paweljw/pomidor/bom.csv

ID | Name | Designator | Footprint | Quantity | Manufacturer Part | Manufacturer | Supplier | Supplier Part
1 | SK12D07VG4 | SW1,SW2 | SW-TH_SK12D07VG4 | 2 | SK12D07VG4 | SHOU HAN | LCSC | C393937
2 | ICS-28P | SK1 | DIP-28_L16.8-W10.1-P2.54-LS7.62-BL | 1 | - | Shenzhen Cankemeng | LCSC | C146582
3 | 16MHz | X1 | OSC-TH_L10.0-W4.5-P5.00 | 1 | X49SD16MSD2SC | YXC | LCSC | C16212
4 | 10nF | C1,C2 | CAP-TH_L5.0-W2.5-P2.54-D0.7 | 2 | CC1H103ZA1FD3F4D10MF | Dersonic | LCSC | C254083
5 | 100 | R3 | RES-TH_BD3.3-L9.0-P13.00-D0.6 | 1 | MFR01SF1000A10 | UniOhm | LCSC | C58690
6 | HMB1206-03 | BUZZER1 | BUZ-TH_BD12.0-P7.60-D0.6-FD | 1 | HMB1206-03 | Jiangsu Huaneng Elec | LCSC | C96101
7 | LF50CV | U1 | TO-220-3_L10.0-W4.5-P2.54-L | 1 | LF50CV | STMicroelectronics | LCSC | C283471
8 | MTP125-1104S1 | H1,H2 | HDR-TH_4P-P2.54-V | 2 | MTP125-1104S1 | MINTRON | LCSC | C358686
9 | 330 | R1 | RES-TH_BD2.2-L6.5-P10.50-D0.6 | 1 | MF1/4CCT52A3300F | KOA Speer Elec | LCSC | C315657
10 | 10K | R2 | RES-TH_BD2.3-L7.1-P11.10-D0.6 | 1 | MF1/4CCT52A1002F | KOA Speer Elec | LCSC | C202434
11 | 670688000 | USB1 | USB-B-TH_67068-8000 | 1 | 670688000 | MOLEX | LCSC | C114097
12 | 100nF | C3 | CAP-TH_L6.0-W6.0-P2.54-D1.0 | 1 | CC1H104ZA1PD3F5O3000 | Dersonic | LCSC | C353909
13 | DSIC03LHGET | SW3 | SW-TH_6P-L9.2-W9.9-P2.54-LS7.6 | 1 | DSIC03LHGET | KE | LCSC | C57448
