paweljw/pomidor/locale.h

#ifndef __LOCALE_H_
#define __LOCALE_H_

#define S_INITIALIZING "   -- init --"
#define S_BANNER "  Pomidor v2.0"
#define S_PRESS_TO_START "  focus, buddy"
#define S_POMODORO "  Pomodoro "
#define S_PAUSED "  -- paused --"
#define S_DONE "   Done! "
#define S_BREAK_TIME "  Break time!"
#define S_FOCUS_TIME " Time to focus!"
#define S_SEP "/"
#define S_SEC_PRE "     "

#endif // __LOCALE_H_
