paweljw/pomidor/(commit log)

2020-10-08 Add the board schematic
2020-10-30 Include example BOM
    [bom.csv]
2020-10-30 Fix a floaty line problem in software
    [pomidor.ino]
